TacosDeSal/Robot_diferencial_Estadias_TSU/Robot diferencial_solid/rueda_loka/rueda_loka.SLDASM

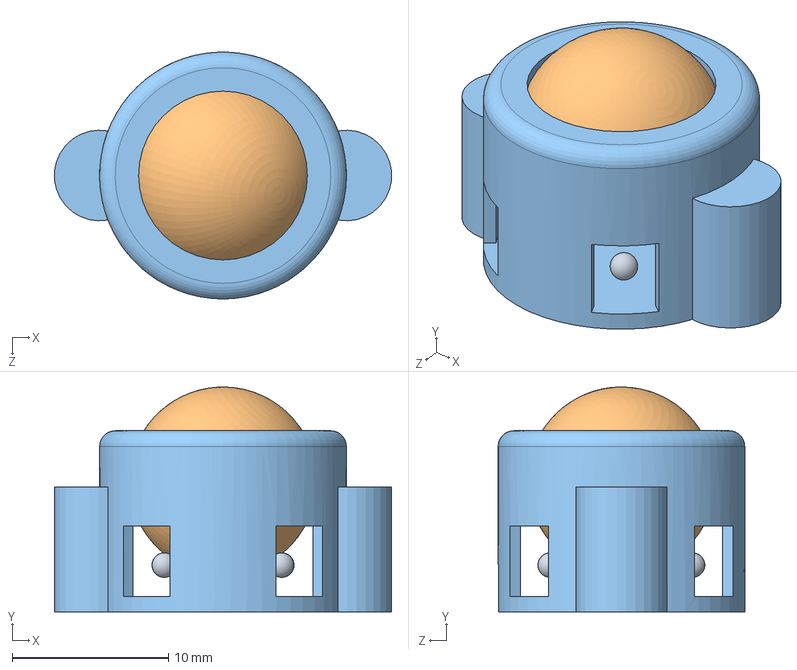
[picture p36: CAD file, 2026-08-19]
Robot diferencial_solid/rueda_loka/rueda_loka.SLDASM
21.6 x 14.4 x 15.8 mm
carcasa_rodillo
esfera_grandeSLDPRT
esfera pequena x 4
