TacosDeSal/Robot_diferencial_Estadias_TSU/Robot diferencial_solid/electronica/HW-411.SLDASM

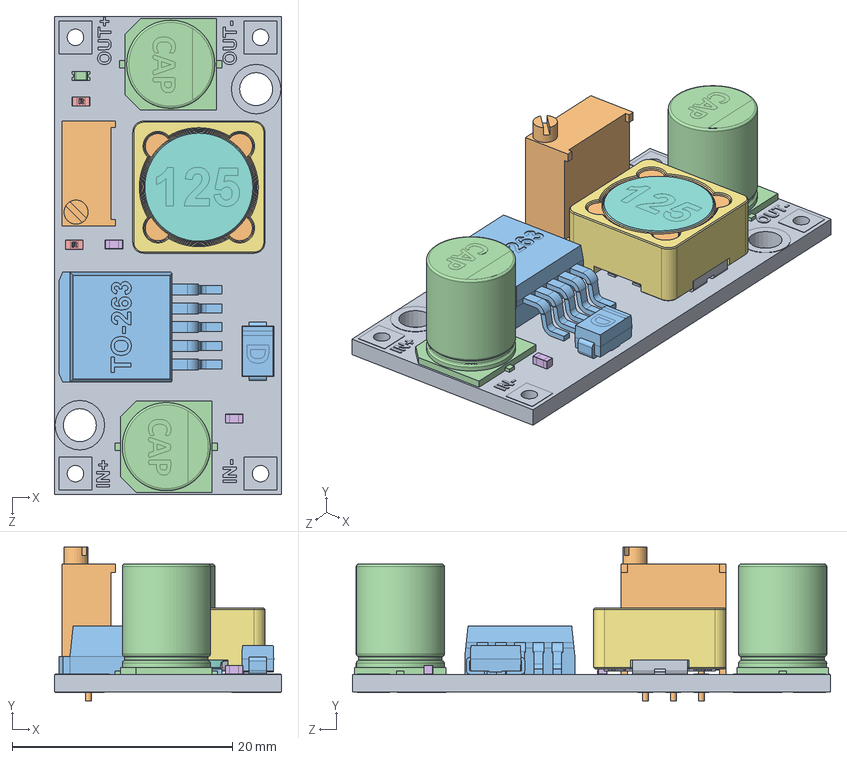
[picture p37: CAD file, 2026-08-19]
Robot diferencial_solid/electronica/HW-411.SLDASM
20.6 x 14.0 x 43.4 mm
Board^HW-411
RES_3296W^HW-411
TO-263-5^HW-411
CAP_SMD_AL_08.0x10.0^HW-411 x 2
RES_SMD_0603^HW-411 x 2
CAP_SMD_0603_H0.50^HW-411 x 2
001^CDRH125_HW-411
002^CDRH125_HW-411
005^CDRH125_HW-411 x 2
003^CDRH125_HW-411
Diode_DO214AC(SMA)^HW-411
LED_0603_Green^HW-411
