TacosDeSal/Robot_diferencial_Estadias_TSU/Robot diferencial_solid/llanta/Ensamblaje_rines.SLDASM

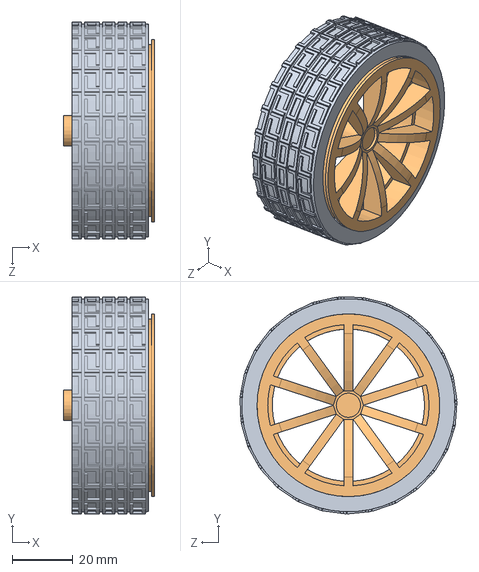
[picture p38: CAD file, 2026-08-19]
Robot diferencial_solid/llanta/Ensamblaje_rines.SLDASM
30.0 x 71.3 x 71.3 mm
Rines_002
Neumatico
