TacosDeSal/Robot_diferencial_Estadias_TSU/Robot diferencial_solid/motor/JGB37-520.SLDASM

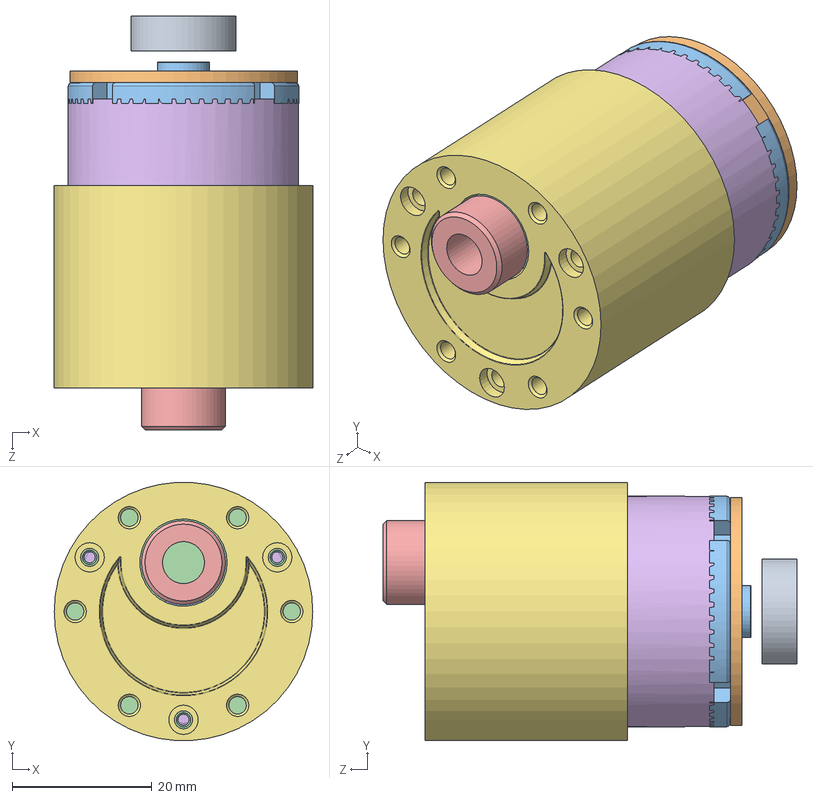
[picture p39: CAD file, 2026-08-19]
Robot diferencial_solid/motor/JGB37-520.SLDASM
37.0 x 36.9 x 59.2 mm
GEARED BODY, MOTOR, JGB37-520
DC MOTOR, JGB37-520
SHAFT COUPLER, JGB37-520
COUPLING BRACKET, GEARED BODY TO DC MOTOR, JGB37-520
PLASTIC COVER, DC MOTOR, JGB37-520
tapa_encoderDPRT
encoder_disk
