TacosDeSal/Robot_diferencial_Estadias_TSU/Robot diferencial_solid/llanta/Neumatico.SLDPRT

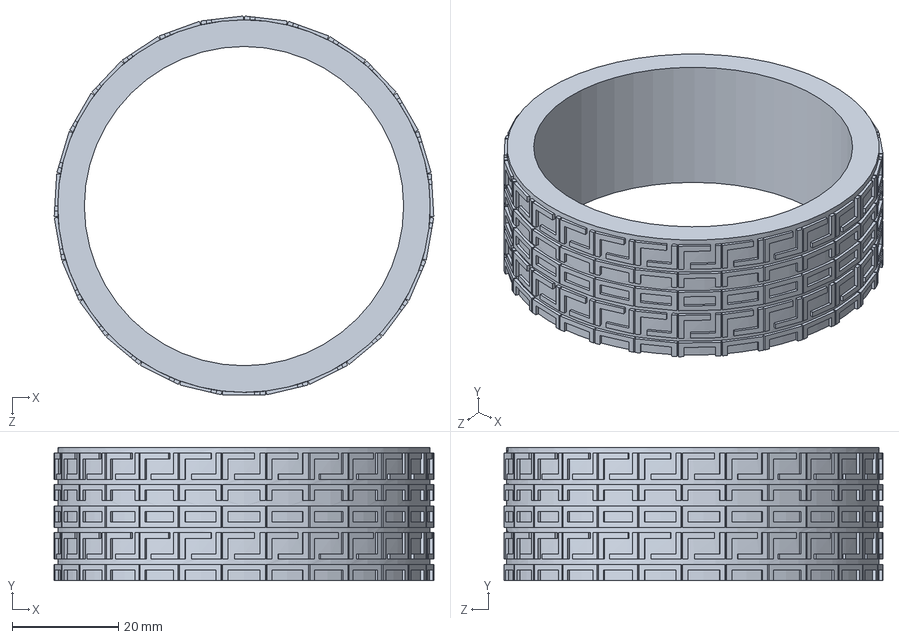
[picture p40: CAD file, 2026-08-19]
Robot diferencial_solid/llanta/Neumatico.SLDPRT
71.3 x 25.0 x 71.2 mm
