TacosDeSal/Robot_diferencial_Estadias_TSU/Robot diferencial_solid/paredes-tapas/pared_trasera_version corta.SLDPRT

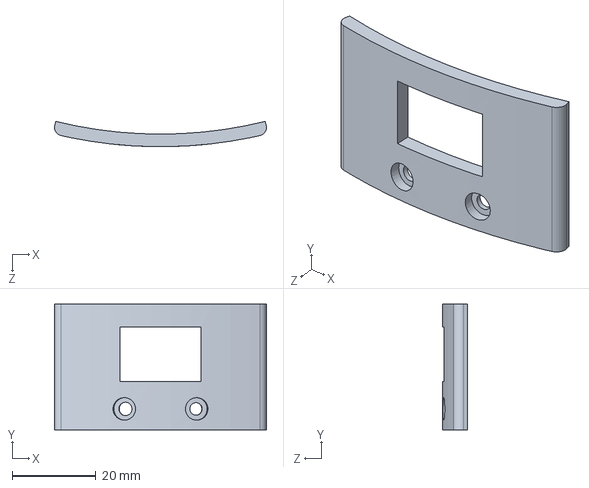
[picture p42: CAD file, 2026-08-19]
Robot diferencial_solid/paredes-tapas/pared_trasera_version corta.SLDPRT
50.6 x 30.0 x 6.01 mm
