TacosDeSal/Robot_diferencial_Estadias_TSU/Robot diferencial_solid/printables/pared_trasera_version corta.STL

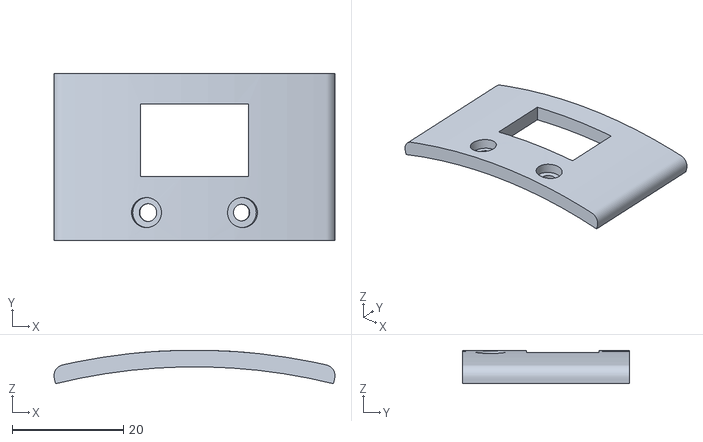
[picture p43: CAD file, 2026-08-19]
Robot diferencial_solid/printables/pared_trasera_version corta.STL
50.6 x 30.0 x 6.01
