TacosDeSal/Robot_diferencial_Estadias_TSU/Robot diferencial_solid/pruebas/Prueba_canales_cables.SLDPRT

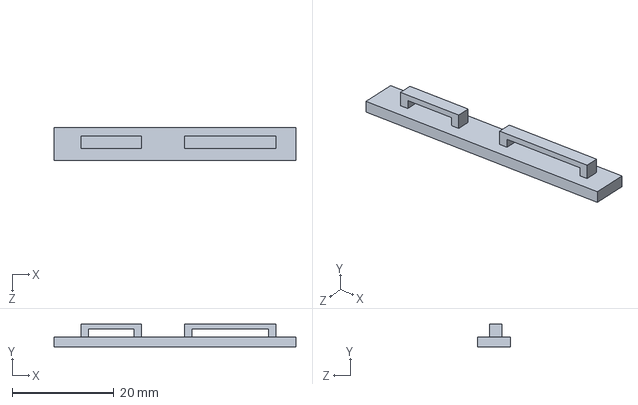
[picture p44: CAD file, 2026-08-19]
Robot diferencial_solid/pruebas/Prueba_canales_cables.SLDPRT
47.7 x 4.50 x 6.50 mm
