TacosDeSal/Robot_diferencial_Estadias_TSU/Robot diferencial_solid/electronica/lipo 12v rectangulo.SLDPRT

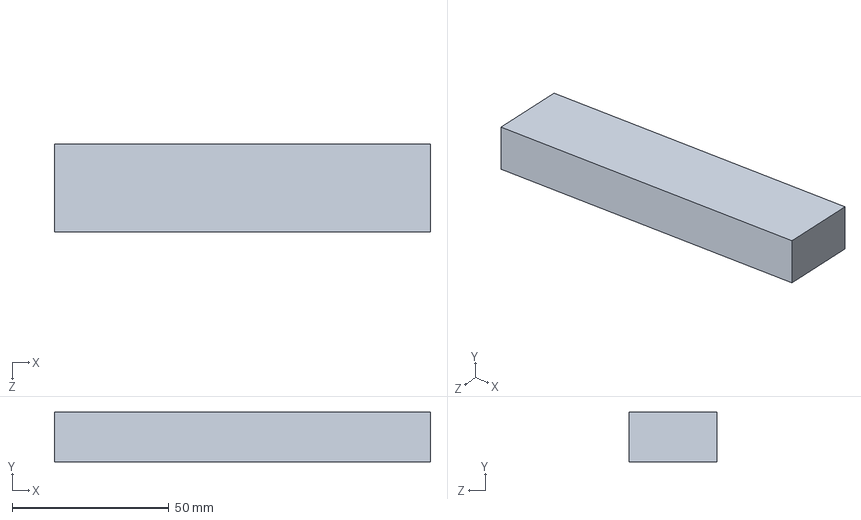
[picture p45: CAD file, 2026-08-19]
Robot diferencial_solid/electronica/lipo 12v rectangulo.SLDPRT
120.0 x 15.8 x 28.0 mm
