TacosDeSal/Robot_diferencial_Estadias_TSU/Robot diferencial_solid/llanta/Rines_002.SLDPRT

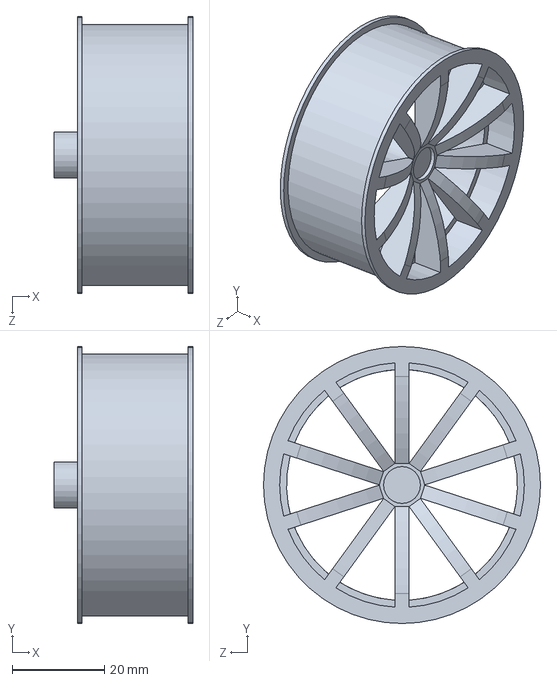
[picture p46: CAD file, 2026-08-19]
Robot diferencial_solid/llanta/Rines_002.SLDPRT
30.0 x 60.0 x 60.0 mm
