TacosDeSal/Robot_diferencial_Estadias_TSU/Robot diferencial_solid/motor/tapa_encoderDPRT.SLDPRT

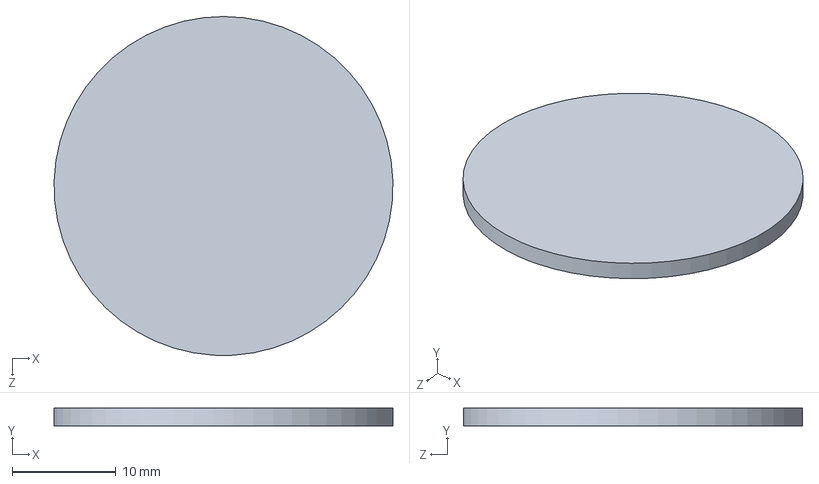
[picture p47: CAD file, 2026-08-19]
Robot diferencial_solid/motor/tapa_encoderDPRT.SLDPRT
32.6 x 1.70 x 32.6 mm
