TacosDeSal/Robot_diferencial_Estadias_TSU/Robot diferencial_solid/paredes-tapas/tapa_superior.SLDPRT

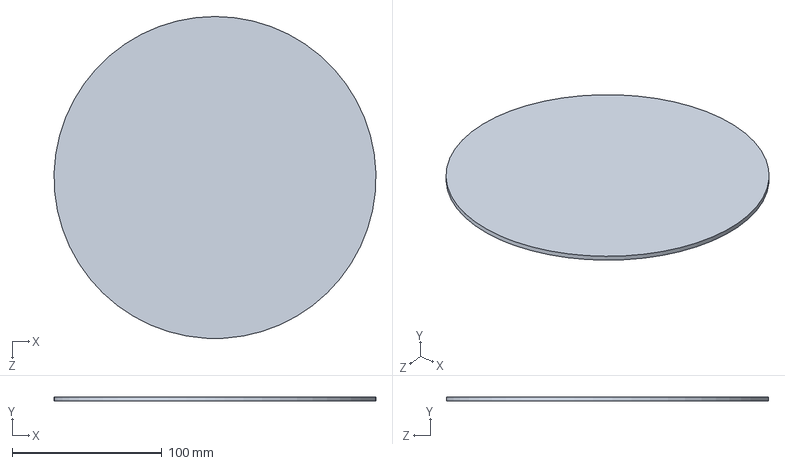
[picture p48: CAD file, 2026-08-19]
Robot diferencial_solid/paredes-tapas/tapa_superior.SLDPRT
214.9 x 3.00 x 215.0 mm
