TacosDeSal/Robot_diferencial_Estadias_TSU/Robot diferencial_solid/printables/tapa_pila.STL

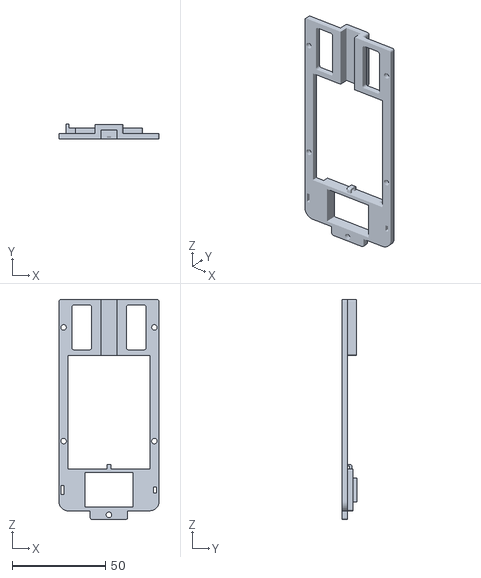
[picture p49: CAD file, 2026-08-19]
Robot diferencial_solid/printables/tapa_pila.STL
53.8 x 8.00 x 118.1
