TacosDeSal/Robot_diferencial_Estadias_TSU/Robot diferencial_solid/pruebas/prueba_modulo_corriente.SLDPRT

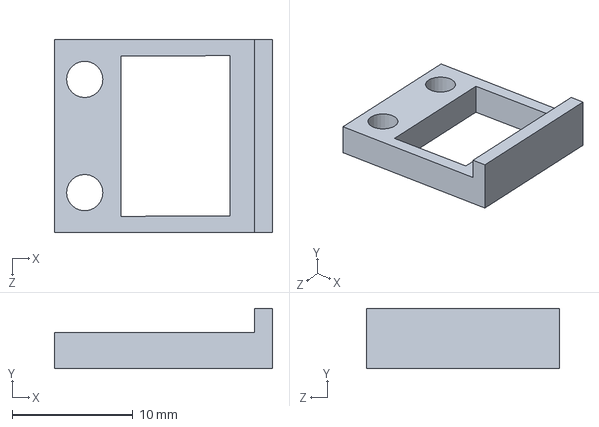
[picture p50: CAD file, 2026-08-19]
Robot diferencial_solid/pruebas/prueba_modulo_corriente.SLDPRT
18.0 x 5.00 x 16.0 mm
