TacosDeSal/Robot_diferencial_Estadias_TSU/Robot diferencial_solid/rueda_loka/esfera pequena.SLDPRT

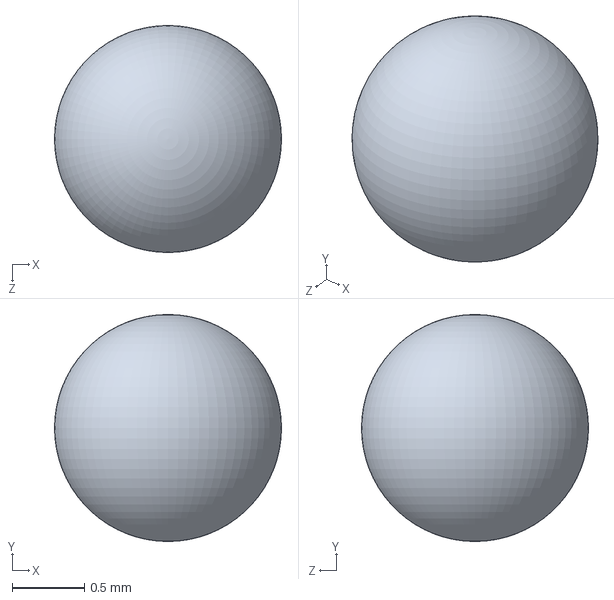
[picture p51: CAD file, 2026-08-19]
Robot diferencial_solid/rueda_loka/esfera pequena.SLDPRT
1.57 x 1.57 x 1.57 mm
