TacosDeSal/Robot_diferencial_Estadias_TSU/Robot diferencial_solid/motor/SHAFT COUPLER, JGB37-520.SLDPRT

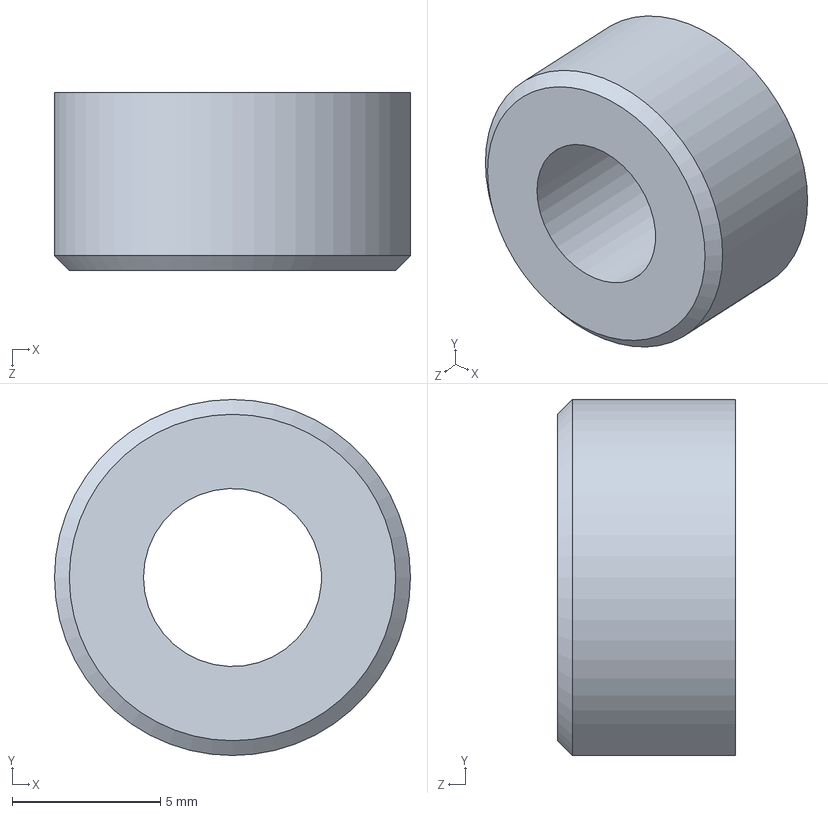
[picture p52: CAD file, 2026-08-19]
Robot diferencial_solid/motor/SHAFT COUPLER, JGB37-520.SLDPRT
12.0 x 12.0 x 6.00 mm
