TacosDeSal/Robot_diferencial_Estadias_TSU/Robot diferencial_solid/paredes-tapas/pared_frontal.SLDPRT

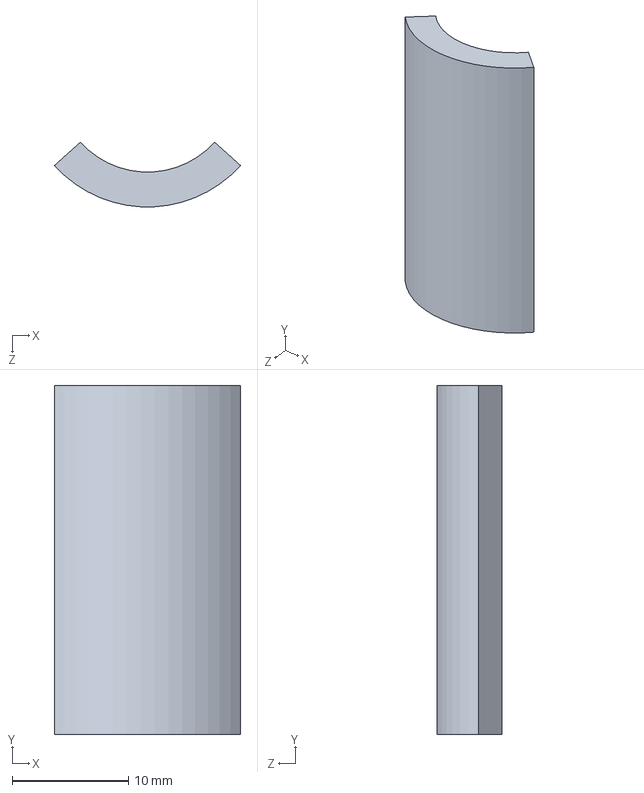
[picture p53: CAD file, 2026-08-19]
Robot diferencial_solid/paredes-tapas/pared_frontal.SLDPRT
16.0 x 30.0 x 5.56 mm
