TacosDeSal/Robot_diferencial_Estadias_TSU/Robot diferencial_solid/printables/base 3.STL

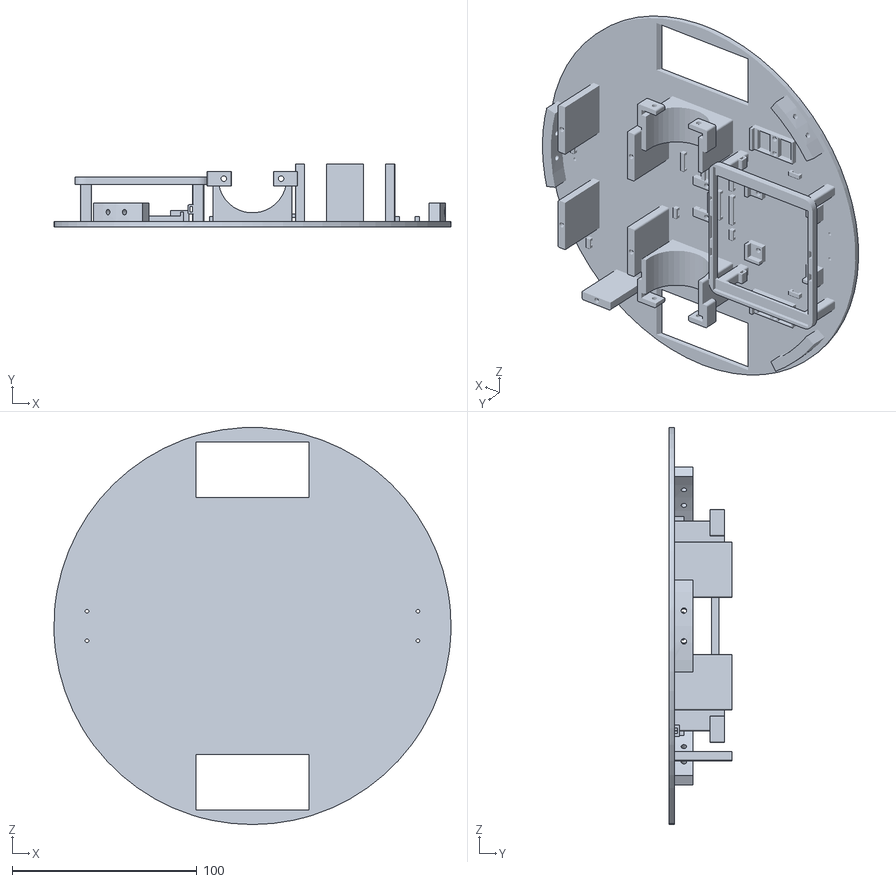
[picture p54: CAD file, 2026-08-19]
Robot diferencial_solid/printables/base 3.STL
215.0 x 34.0 x 215.0
