TacosDeSal/Robot_diferencial_Estadias_TSU/Robot diferencial_solid/pruebas/prueba_puente_h.SLDPRT

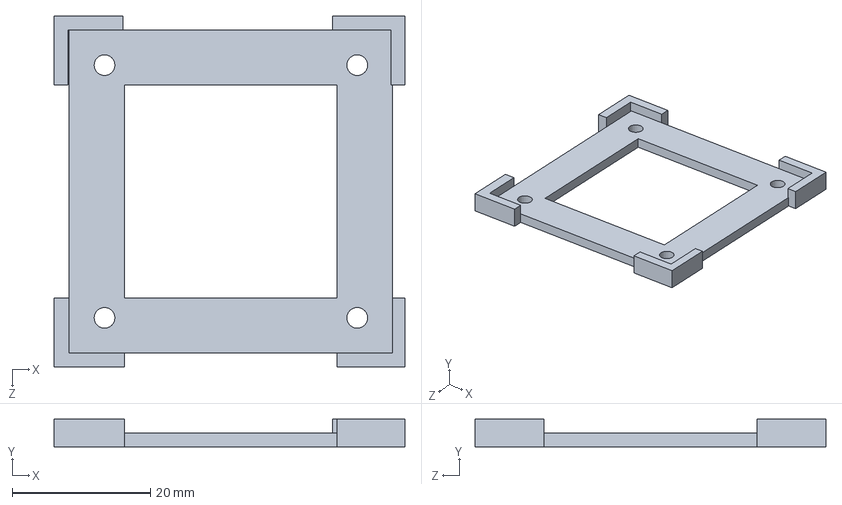
[picture p55: CAD file, 2026-08-19]
Robot diferencial_solid/pruebas/prueba_puente_h.SLDPRT
50.7 x 4.00 x 50.7 mm
