TacosDeSal/Robot_diferencial_Estadias_TSU/Robot diferencial_solid/puente_h/TB6612FNG_Lower Pins.SLDPRT

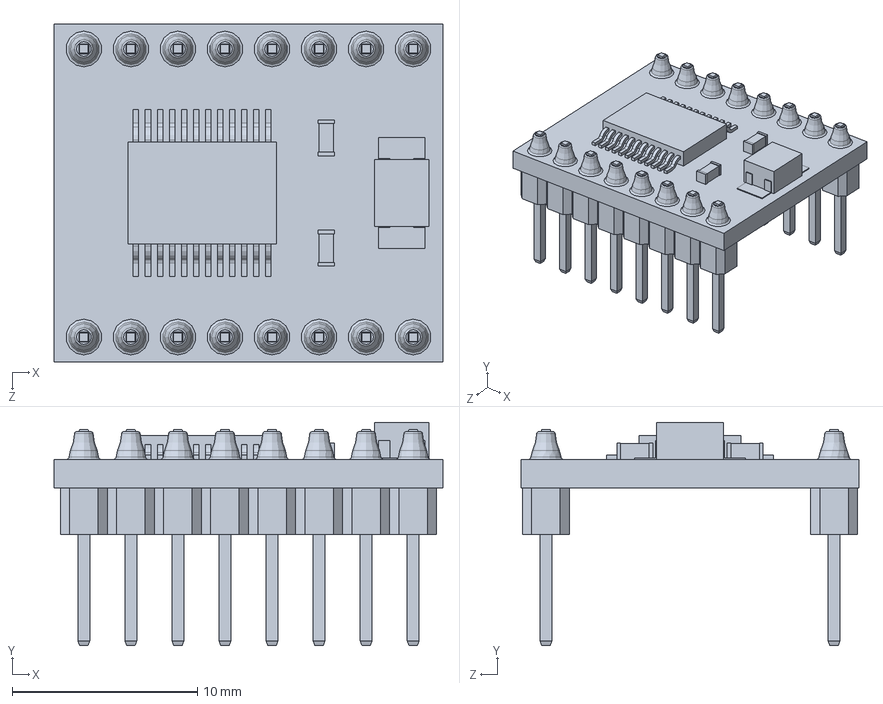
[picture p56: CAD file, 2026-08-19]
Robot diferencial_solid/puente_h/TB6612FNG_Lower Pins.SLDPRT
21.0 x 12.1 x 18.2 mm
