TacosDeSal/Robot_diferencial_Estadias_TSU/Robot diferencial_solid/rueda_loka/carcasa_rodillo.SLDPRT

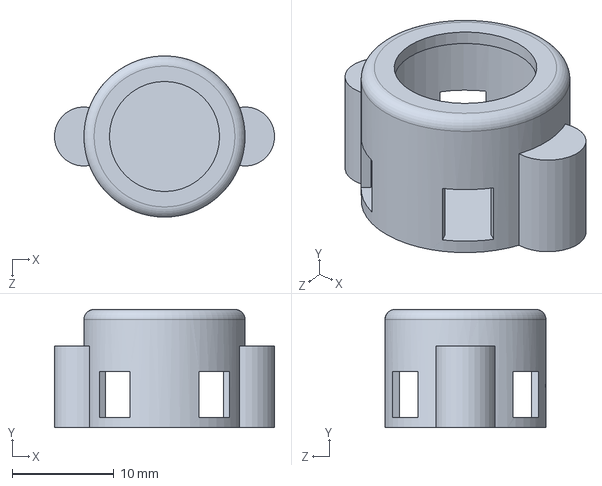
[picture p57: CAD file, 2026-08-19]
Robot diferencial_solid/rueda_loka/carcasa_rodillo.SLDPRT
21.6 x 11.6 x 15.8 mm
