TacosDeSal/Robot_diferencial_Estadias_TSU/Robot diferencial_solid/stuff/Bloque de terminales 2 verde.SLDPRT

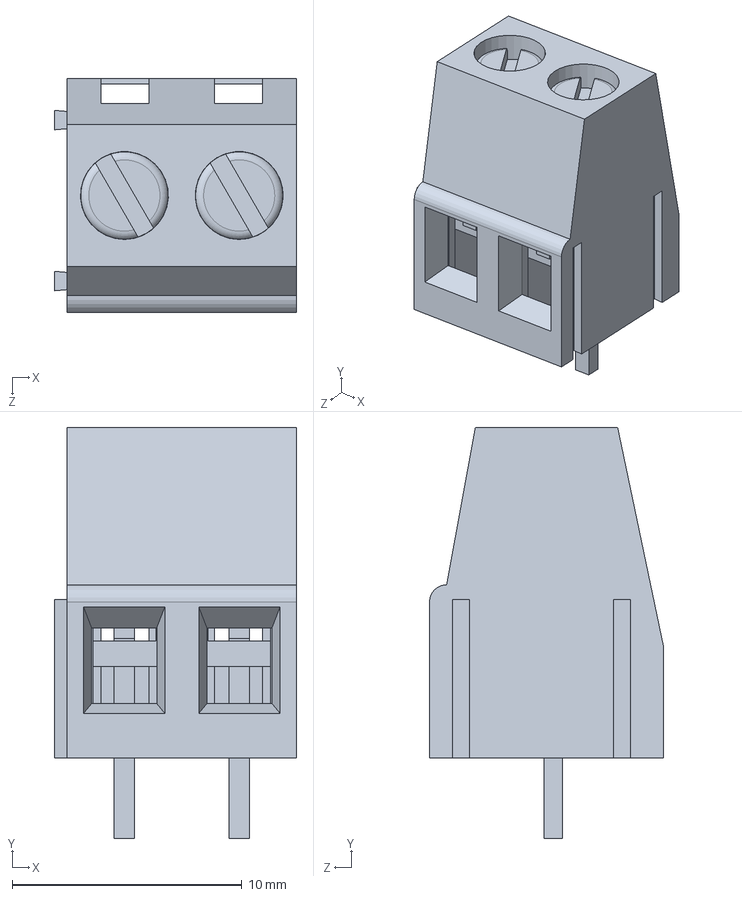
[picture p58: CAD file, 2026-08-19]
Robot diferencial_solid/stuff/Bloque de terminales 2 verde.SLDPRT
10.6 x 17.9 x 10.2 mm
