TacosDeSal/Robot_diferencial_Estadias_TSU/Robot diferencial_solid/paredes-tapas/base 3.SLDPRT

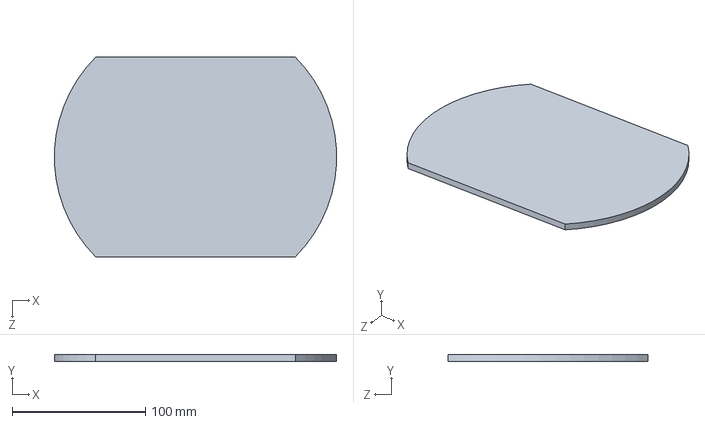
[picture p59: CAD file, 2026-08-19]
Robot diferencial_solid/paredes-tapas/base 3.SLDPRT
211.8 x 5.00 x 150.0 mm
