TacosDeSal/Robot_diferencial_Estadias_TSU/Robot diferencial_solid/printables/pared_trasera.STL

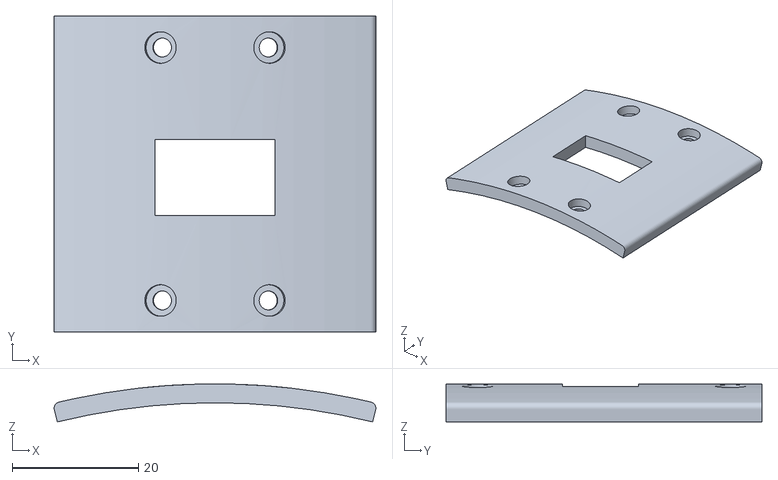
[picture p60: CAD file, 2026-08-19]
Robot diferencial_solid/printables/pared_trasera.STL
51.0 x 50.1 x 6.01
