TacosDeSal/Robot_diferencial_Estadias_TSU/Robot diferencial_solid/pruebas/prueba_imu.SLDPRT

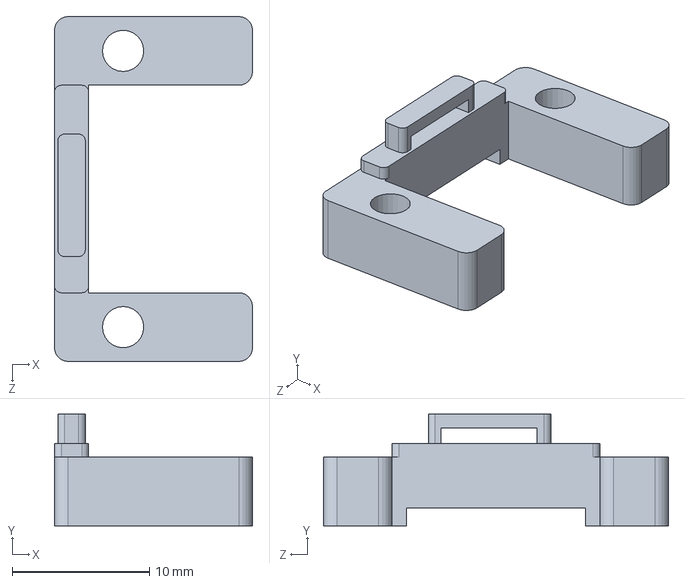
[picture p61: CAD file, 2026-08-19]
Robot diferencial_solid/pruebas/prueba_imu.SLDPRT
14.4 x 8.14 x 25.1 mm
