TacosDeSal/Robot_diferencial_Estadias_TSU/Robot diferencial_solid/rueda_loka/esfera_grandeSLDPRT.SLDPRT

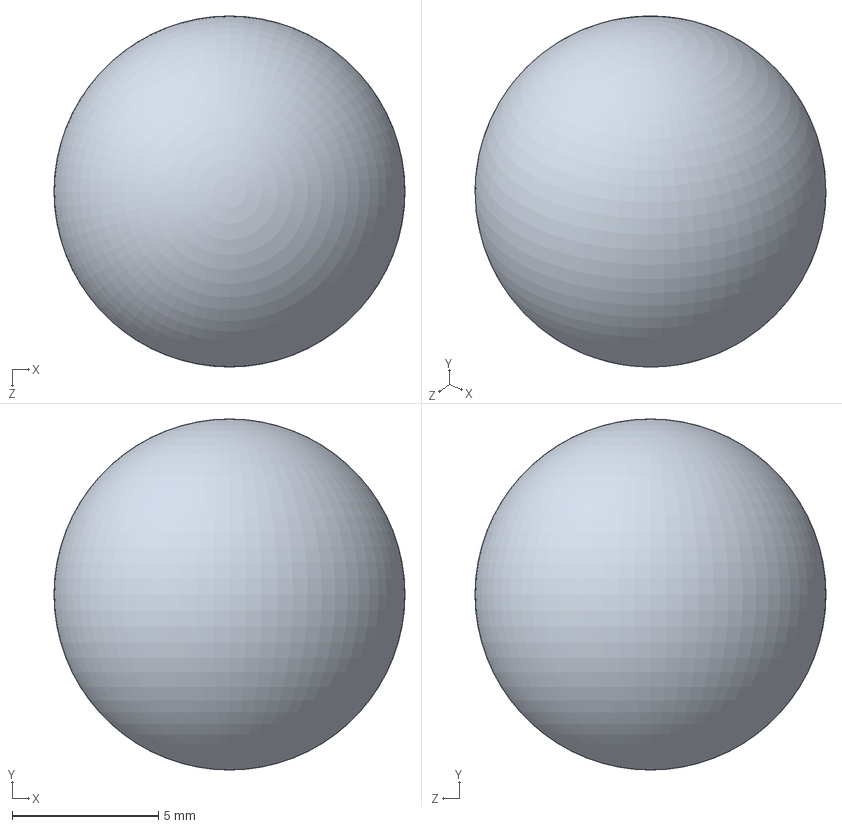
[picture p62: CAD file, 2026-08-19]
Robot diferencial_solid/rueda_loka/esfera_grandeSLDPRT.SLDPRT
12.0 x 12.0 x 12.0 mm
