TacosDeSal/Robot_diferencial_Estadias_TSU/Robot diferencial_solid/stuff/tru_bracket.SLDPRT

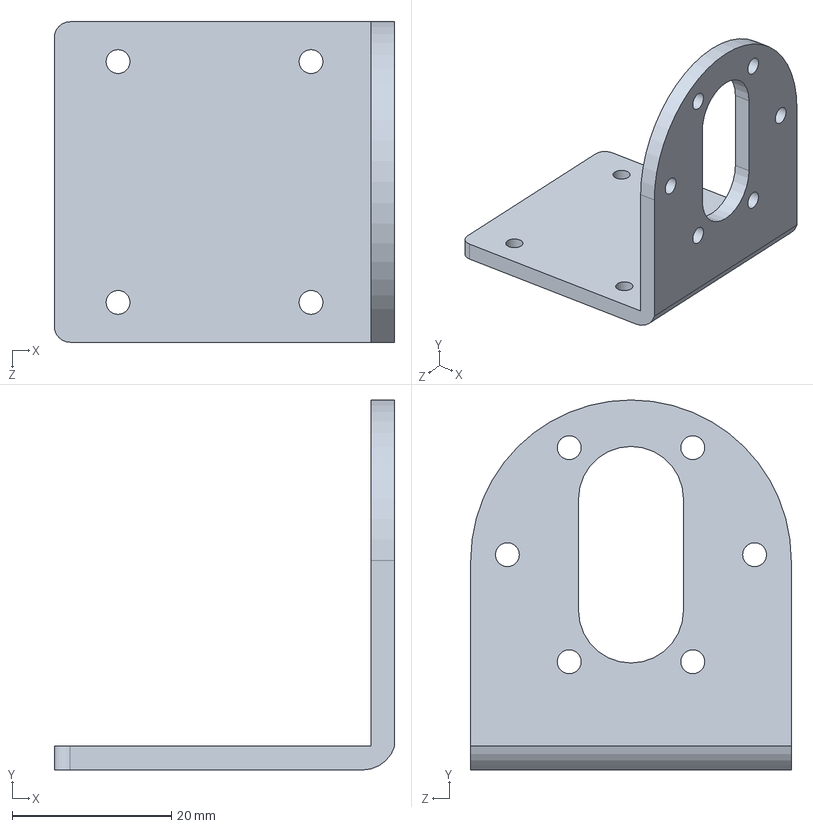
[picture p63: CAD file, 2026-08-19]
Robot diferencial_solid/stuff/tru_bracket.SLDPRT
42.7 x 46.4 x 40.2 mm
