TacosDeSal/Robot_diferencial_Estadias_TSU/Robot diferencial_solid/electronica/tru_IMU_GYICM2048.SLDPRT

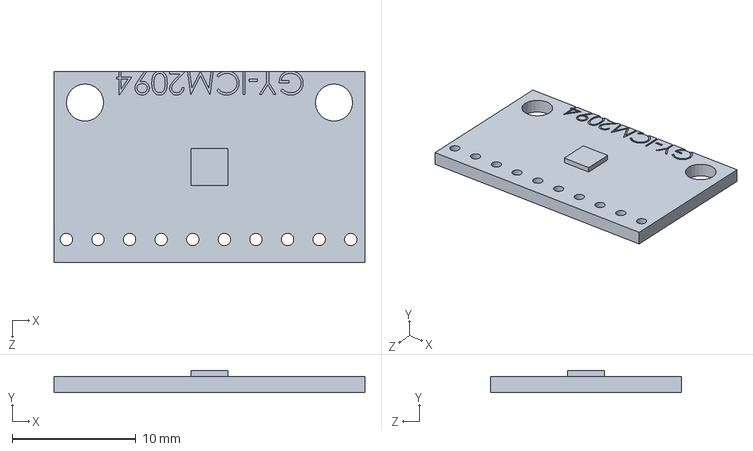
[picture p64: CAD file, 2026-08-19]
Robot diferencial_solid/electronica/tru_IMU_GYICM2048.SLDPRT
25.1 x 1.80 x 15.4 mm
