TacosDeSal/Robot_diferencial_Estadias_TSU/Robot diferencial_solid/motor/COUPLING BRACKET, GEARED BODY TO DC MOTOR, JGB37-520.SLDPRT

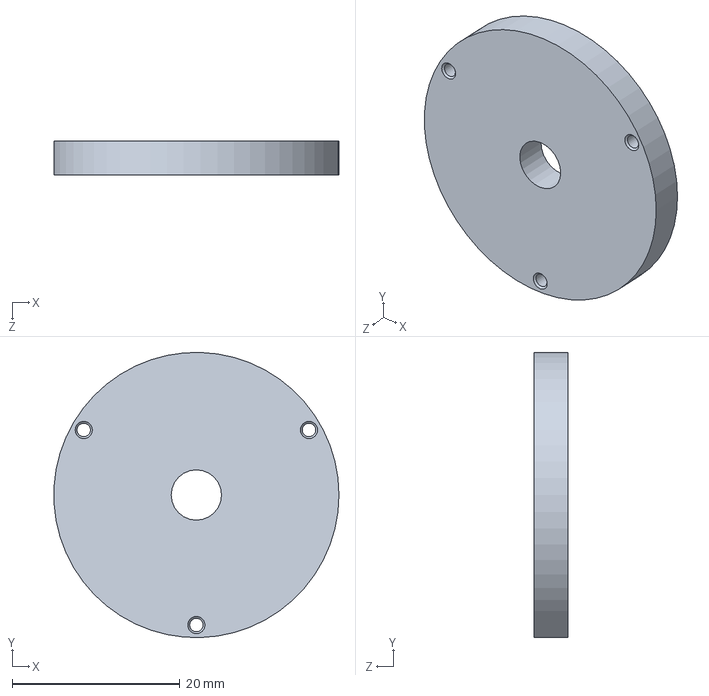
[picture p65: CAD file, 2026-08-19]
Robot diferencial_solid/motor/COUPLING BRACKET, GEARED BODY TO DC MOTOR, JGB37-520.SLDPRT
34.0 x 34.0 x 4.00 mm
