TacosDeSal/Robot_diferencial_Estadias_TSU/Robot diferencial_solid/pruebas/prueba_bracket_motor.SLDPRT

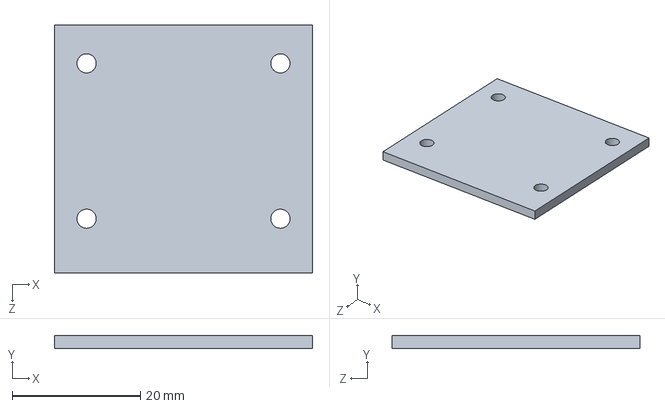
[picture p66: CAD file, 2026-08-19]
Robot diferencial_solid/pruebas/prueba_bracket_motor.SLDPRT
40.2 x 2.00 x 38.7 mm
