TacosDeSal/Robot_diferencial_Estadias_TSU/Robot diferencial_solid/electronica/IMU_GY_ICM2048.SLDPRT

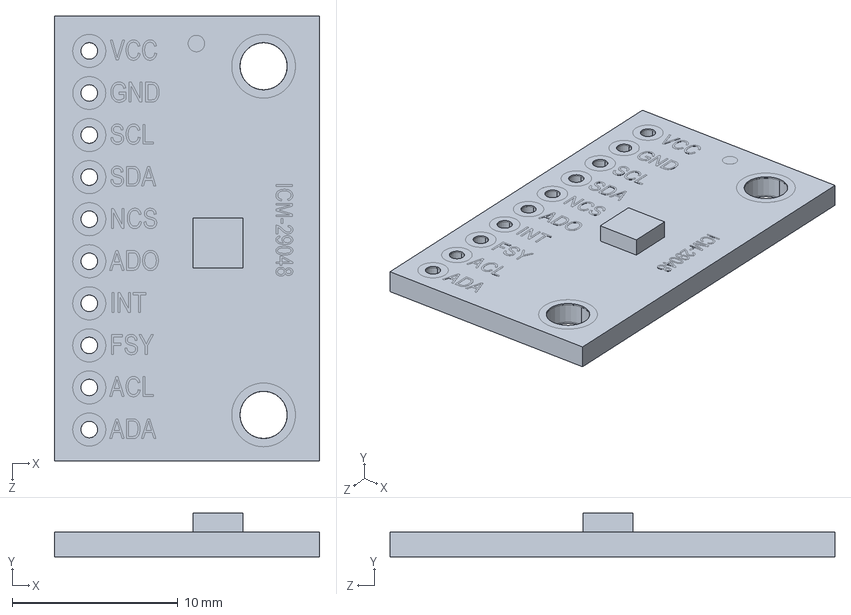
[picture p67: CAD file, 2026-08-19]
Robot diferencial_solid/electronica/IMU_GY_ICM2048.SLDPRT
16.0 x 2.65 x 26.9 mm
