TacosDeSal/Robot_diferencial_Estadias_TSU/Robot diferencial_solid/motor/PLASTIC COVER, DC MOTOR, JGB37-520.SLDPRT

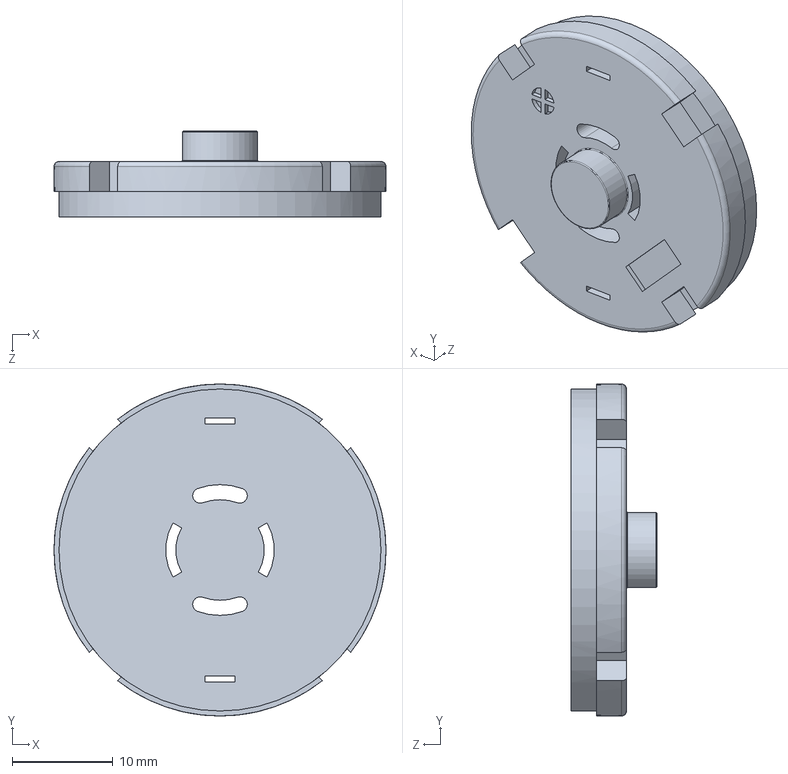
[picture p68: CAD file, 2026-08-19]
Robot diferencial_solid/motor/PLASTIC COVER, DC MOTOR, JGB37-520.SLDPRT
33.0 x 33.0 x 8.50 mm
