TacosDeSal/Robot_diferencial_Estadias_TSU/Robot diferencial_solid/pruebas/prueba_base rueda loka.SLDPRT

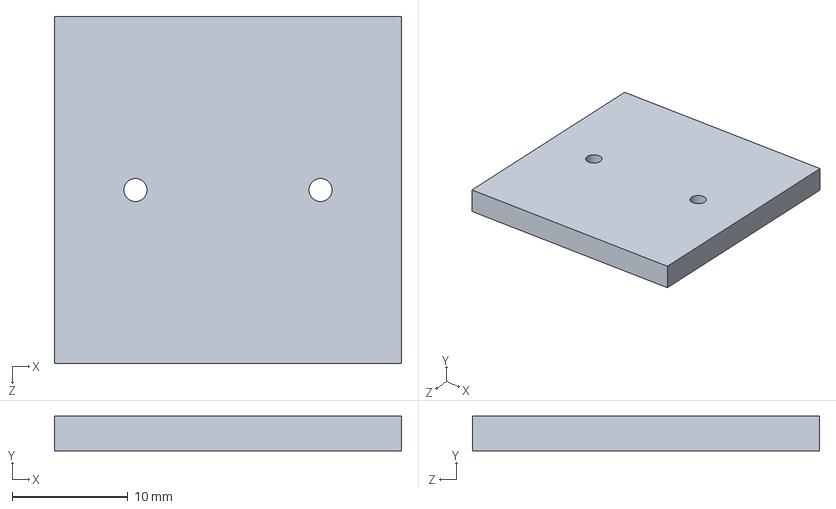
[picture p69: CAD file, 2026-08-19]
Robot diferencial_solid/pruebas/prueba_base rueda loka.SLDPRT
30.0 x 3.00 x 30.0 mm
