TacosDeSal/Robot_diferencial_Estadias_TSU/Robot diferencial_solid/puente_h/placa_perforada_steren.SLDPRT

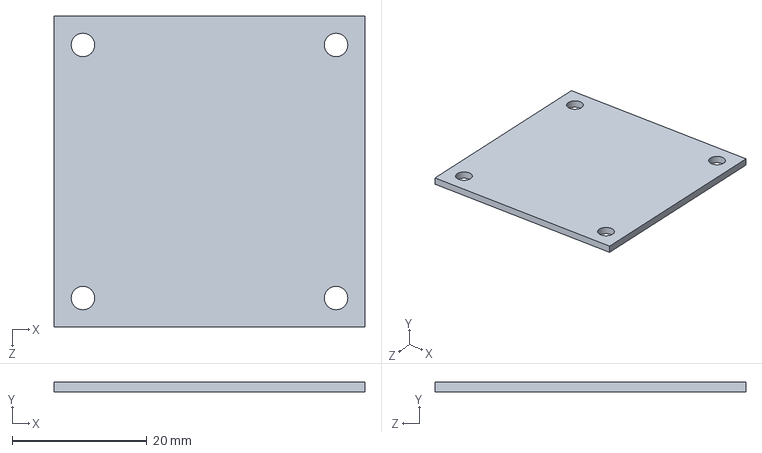
[picture p70: CAD file, 2026-08-19]
Robot diferencial_solid/puente_h/placa_perforada_steren.SLDPRT
46.2 x 1.50 x 46.2 mm
