TacosDeSal/Robot_diferencial_Estadias_TSU/Robot diferencial_solid/electronica/lipo 7,4v.SLDPRT

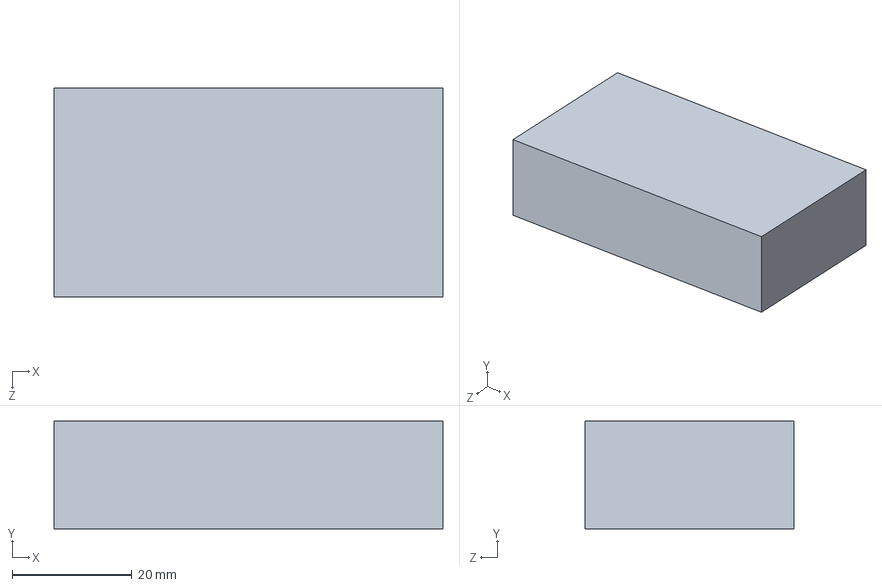
[picture p71: CAD file, 2026-08-19]
Robot diferencial_solid/electronica/lipo 7,4v.SLDPRT
65.0 x 18.0 x 35.0 mm
