TacosDeSal/Robot_diferencial_Estadias_TSU/Robot diferencial_solid/motor/encoder_disk.SLDPRT

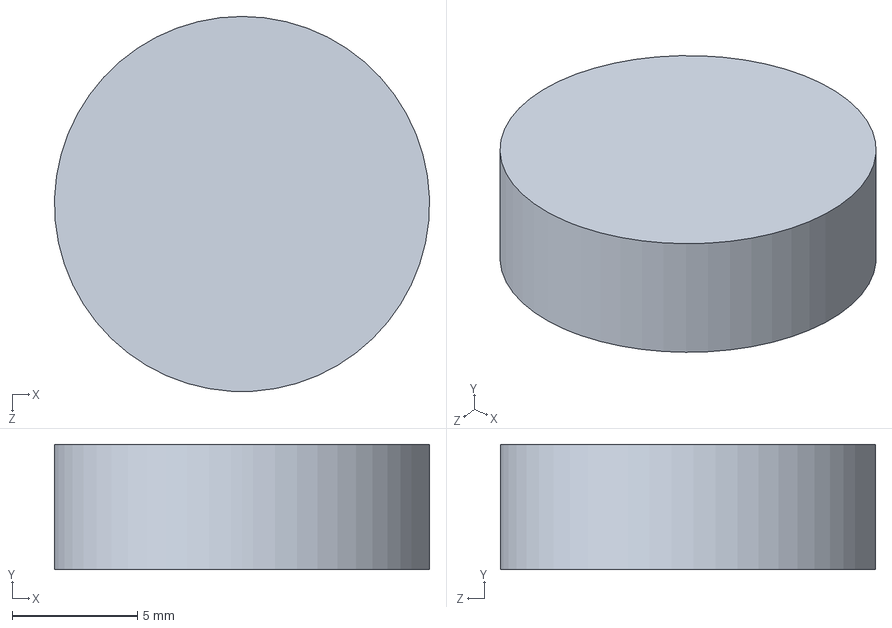
[picture p72: CAD file, 2026-08-19]
Robot diferencial_solid/motor/encoder_disk.SLDPRT
15.0 x 5.00 x 15.0 mm
