TacosDeSal/Robot_diferencial_Estadias_TSU/Robot diferencial_solid/pruebas/prueba_base_motor.SLDPRT

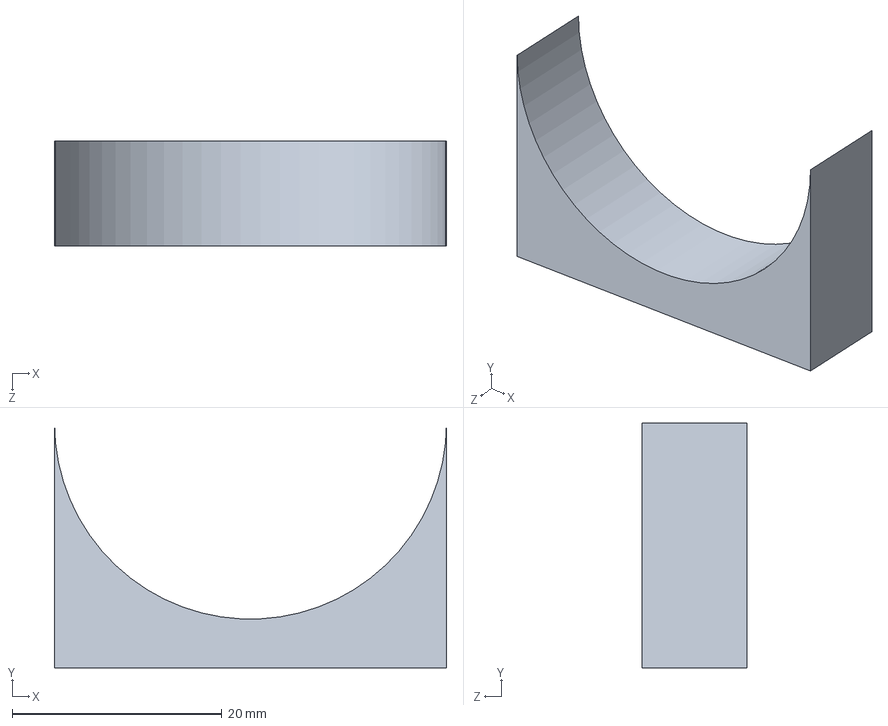
[picture p73: CAD file, 2026-08-19]
Robot diferencial_solid/pruebas/prueba_base_motor.SLDPRT
37.4 x 23.3 x 10.0 mm
