TacosDeSal/Robot_diferencial_Estadias_TSU/Robot diferencial_solid/stuff/terminal_adapter_base.SLDPRT

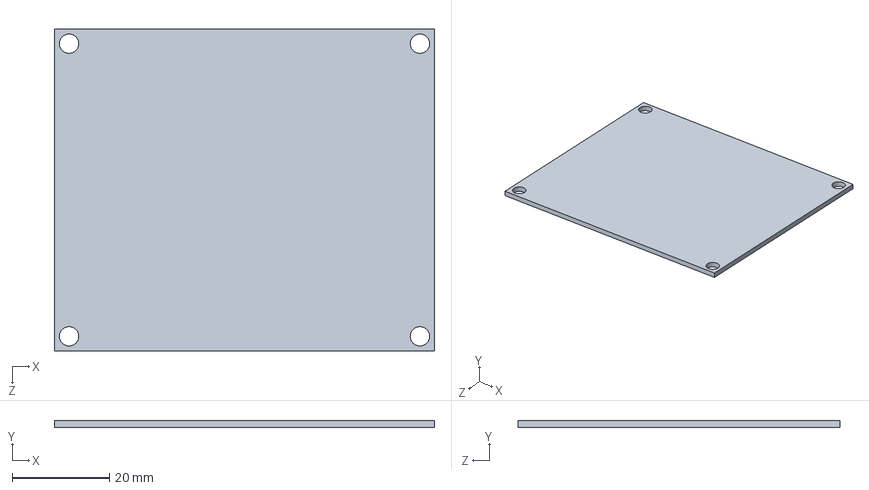
[picture p74: CAD file, 2026-08-19]
Robot diferencial_solid/stuff/terminal_adapter_base.SLDPRT
78.3 x 1.50 x 66.3 mm
