TacosDeSal/Robot_diferencial_Estadias_TSU/Robot diferencial_solid/motor/GEARED BODY, MOTOR, JGB37-520.SLDPRT

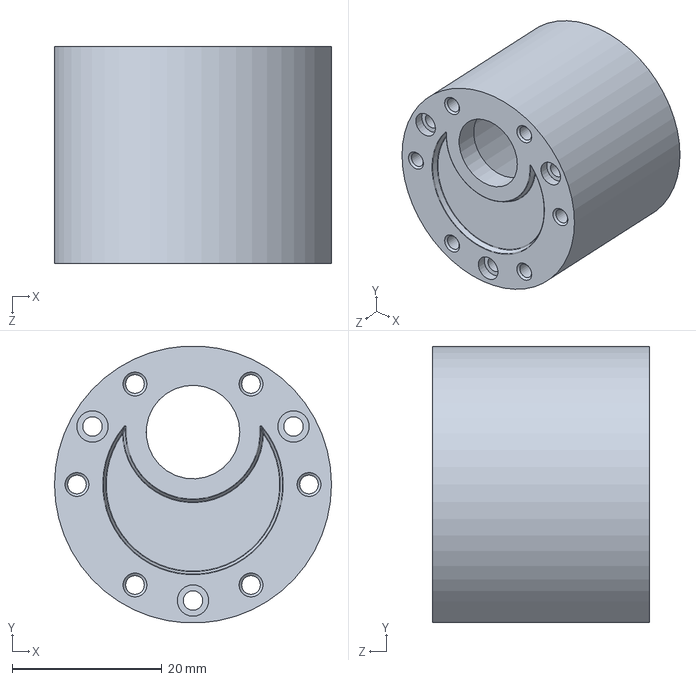
[picture p75: CAD file, 2026-08-19]
Robot diferencial_solid/motor/GEARED BODY, MOTOR, JGB37-520.SLDPRT
37.0 x 36.9 x 29.0 mm
