TacosDeSal/Robot_diferencial_Estadias_TSU/Robot diferencial_solid/motor/CONNECTION, DC MOTOR, JGB37-520.SLDPRT

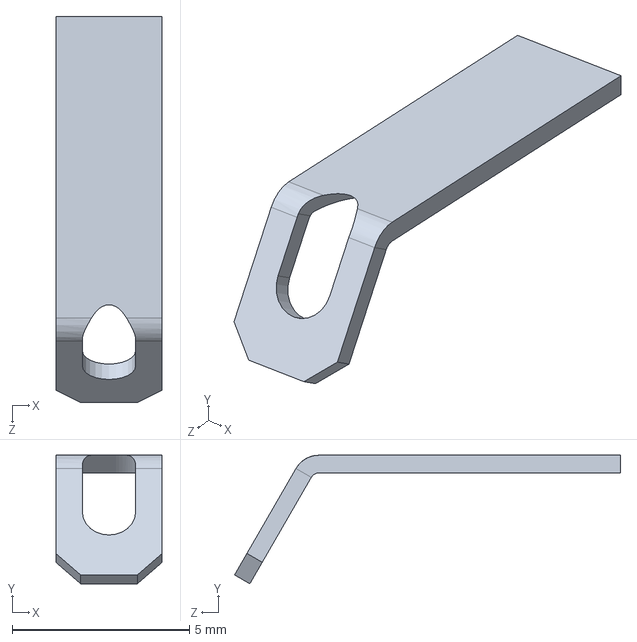
[picture p76: CAD file, 2026-08-19]
Robot diferencial_solid/motor/CONNECTION, DC MOTOR, JGB37-520.SLDPRT
3.00 x 3.62 x 10.9 mm
