TacosDeSal/Robot_diferencial_Estadias_TSU/Robot diferencial_solid/motor/MOTOR SHAFT, JGB37-520.SLDPRT

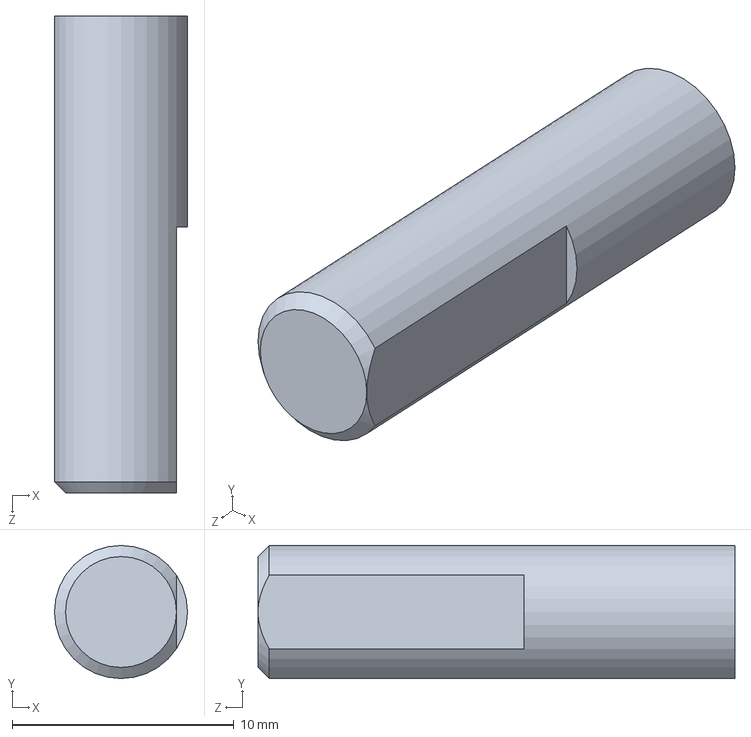
[picture p77: CAD file, 2026-08-19]
Robot diferencial_solid/motor/MOTOR SHAFT, JGB37-520.SLDPRT
6.00 x 6.00 x 21.5 mm
