TacosDeSal/Robot_diferencial_Estadias_TSU/Robot diferencial_solid/motor/shaft_encoder.SLDPRT

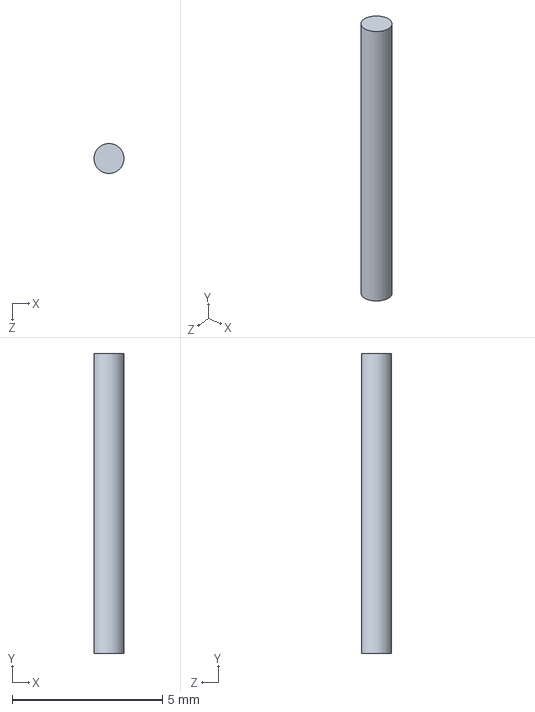
[picture p78: CAD file, 2026-08-19]
Robot diferencial_solid/motor/shaft_encoder.SLDPRT
0.996 x 10.0 x 1.00 mm
