TacosDeSal/Robot_diferencial_Estadias_TSU/Robot diferencial_solid/puente_h/tru_terminal_block_2 pin.SLDASM

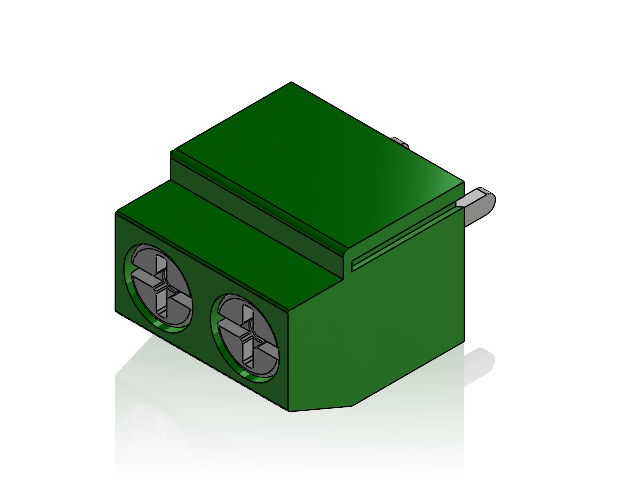
[picture p79: CAD file, 2026-08-19]
Robot diferencial_solid/puente_h/tru_terminal_block_2 pin.SLDASM
KLS2-126_pin_body.stp x 2
KLS2-126_spring.stp x 2
KLS2-126_screw_S.stp x 2
KLS2-126-5.0-02P_body.stp
