TacosDeSal/Robot_diferencial_Estadias_TSU/Robot diferencial_solid/puente_h/tru_terminal 4 block.SLDASM

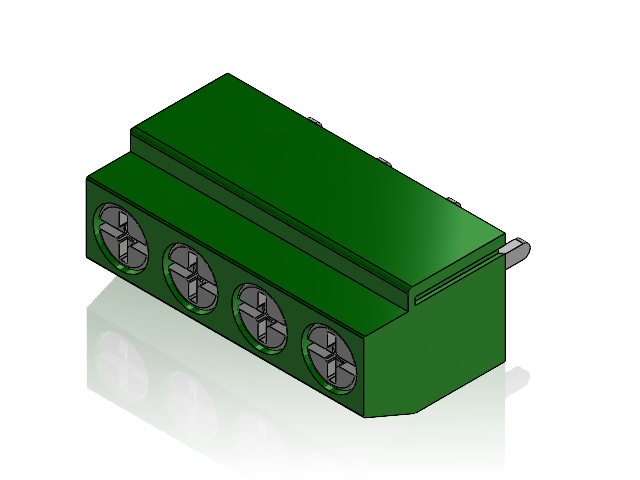
[picture p80: CAD file, 2026-08-19]
Robot diferencial_solid/puente_h/tru_terminal 4 block.SLDASM
KLS2-126_pin_body_1.stp x 4
KLS2-126_spring_1.stp x 4
KLS2-126_screw_S.stp x 4
KLS2-126-5.0-04P_body.stp
