TacosDeSal/Robot_diferencial_Estadias_TSU/Robot diferencial_solid/electronica/DEVELOPMENT BOARD (1).SLDASM

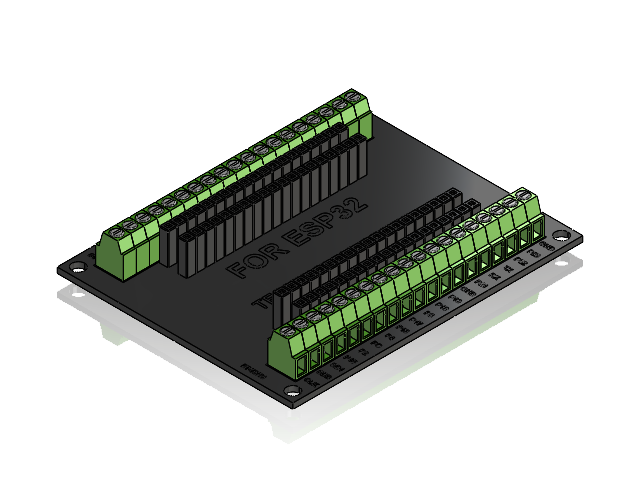
[picture p81: CAD file, 2026-08-19]
Robot diferencial_solid/electronica/DEVELOPMENT BOARD (1).SLDASM
Dupont Pin.STEP_4.STEP.STEP x 19
1x19 Position 2.54mm Pitch Female Header.STEP_4.STEP.STEP
Dupont Pin.STEP-0_4.STEP.STEP x 57
1x19 Position 2.54mm Pitch Female Header.STEP-1_4.STEP.STEP x 3
CIRCUIT BOARD.STEP_4.STEP.STEP
KF128-3.5-2P.STEP_3.STEP.STEP x 2
KF128-3.5-5P.STEP_3.STEP.STEP x 2
KF128-3.5-6P.STEP_3.STEP.STEP x 4
