TacosDeSal/Robot_diferencial_Estadias_TSU/Robot diferencial_solid/puente_h/Puente_H.SLDASM

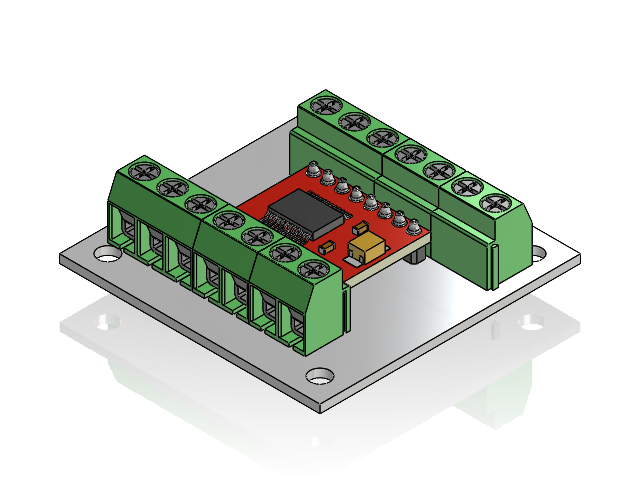
[picture p82: CAD file, 2026-08-19]
Robot diferencial_solid/puente_h/Puente_H.SLDASM
placa_perforada_steren
KLS2-126_pin_body_2.stp x 6
KLS2-126_spring_2.stp x 6
KLS2-126_screw_S.stp x 14
KLS2-126-5.0-03P_body.stp x 2
KLS2-126_pin_body.stp x 8
KLS2-126_spring.stp x 8
KLS2-126-5.0-02P_body.stp x 4
TB6612FNG_Lower Pins
