TacosDeSal/Robot_diferencial_Estadias_TSU/Robot diferencial_solid/puente_h/tru_terminal 3 block.SLDASM

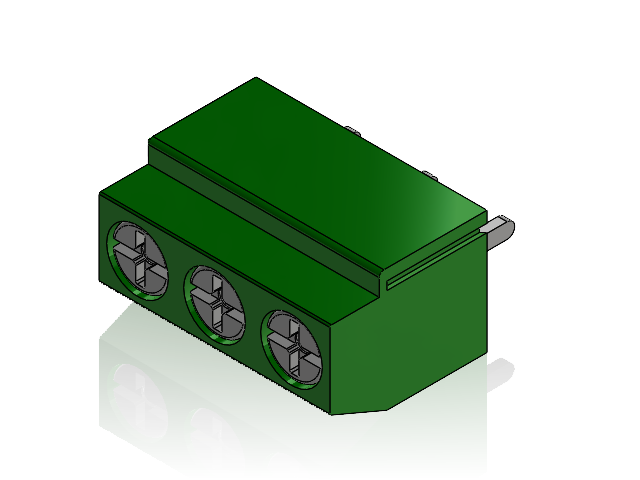
[picture p83: CAD file, 2026-08-19]
Robot diferencial_solid/puente_h/tru_terminal 3 block.SLDASM
KLS2-126_pin_body_2.stp x 3
KLS2-126_spring_2.stp x 3
KLS2-126_screw_S.stp x 3
KLS2-126-5.0-03P_body.stp
