TacosDeSal/Robot_diferencial_Estadias_TSU/(list of files, cad)

Other CAD files:
Robot diferencial_solid/electronica/IC_ACS712_001_1.STEP.SLDPRT
Robot diferencial_solid/stuff/SMD_LED_rot_001_1.STEP.SLDPRT
Robot diferencial_solid/stuff/SMD_DIODE_0.9mm_001_1.STEP.SLDPRT
Robot diferencial_solid/paredes-tapas/tapa_pila.SLDPRT
Robot diferencial_solid/stuff/SMD_R_001_1.STEP.SLDPRT
Robot diferencial_solid/paredes-tapas/pared_trasera_completa.SLDPRT
Robot diferencial_solid/stuff/pines.SLDPRT
Robot diferencial_solid/electronica/ACS712_platine_001_1.STEP.SLDPRT
Robot diferencial_solid/stuff/SMD_DIODE_0.9mm_002_1.STEP.SLDPRT
Robot diferencial_solid/pruebas/Prueba_canales_cables.STL
Robot diferencial_solid/pruebas/prueba_base rueda loka.STL
Robot diferencial_solid/pruebas/prueba_base_motor.STL
Robot diferencial_solid/pruebas/prueba_bracket_motor.STL
Robot diferencial_solid/pruebas/prueba_imu.STL
Robot diferencial_solid/pruebas/prueba_modulo_corriente.STL
Robot diferencial_solid/pruebas/prueba_puente_h.STL
